BadgePiratesLLC/BSidesKC_2023/PICS/back.jpg

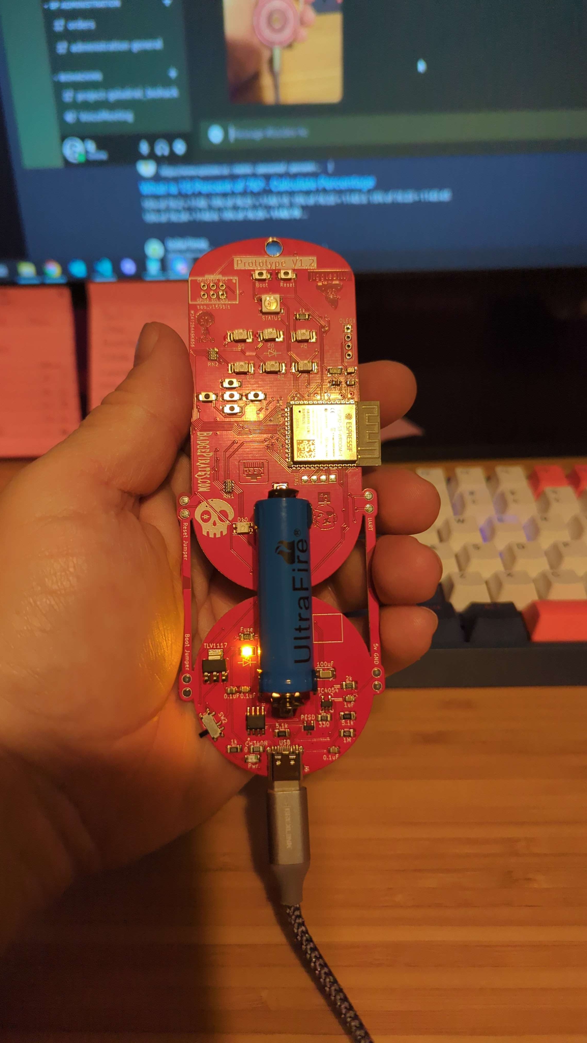
PICS/back.jpg
