BadgePiratesLLC/BSidesKC_2023/PICS/BSidesKC23_Front.png

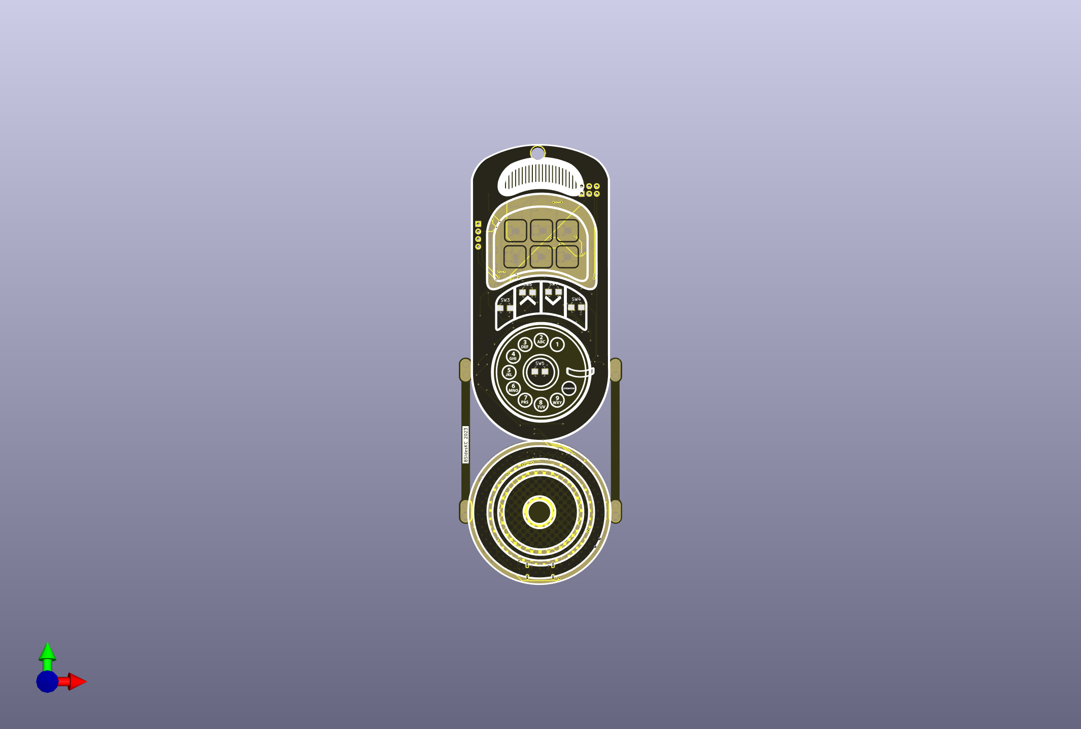
PICS/BSidesKC23_Front.png
