BadgePiratesLLC/BSidesKC_2023/DOCS/PinOut.txt

LEDS - IO10
LEDS - IO11
LEDS - IO12
LEDS - IO13
LEDS - IO14
LEDS - IO15

Status RGB - IO18

OLED SDA - IO06
OLED SDL - IO07

RGB - IO03
RGB - IO04
RGB - IO05

buttons Right - IO35
button Center - IO36
button Up - IO37
button Down - IO38
button Left - IO46
