BadgePiratesLLC/BSidesKC_2023/CTF/CTF Signs QR Codes.docx

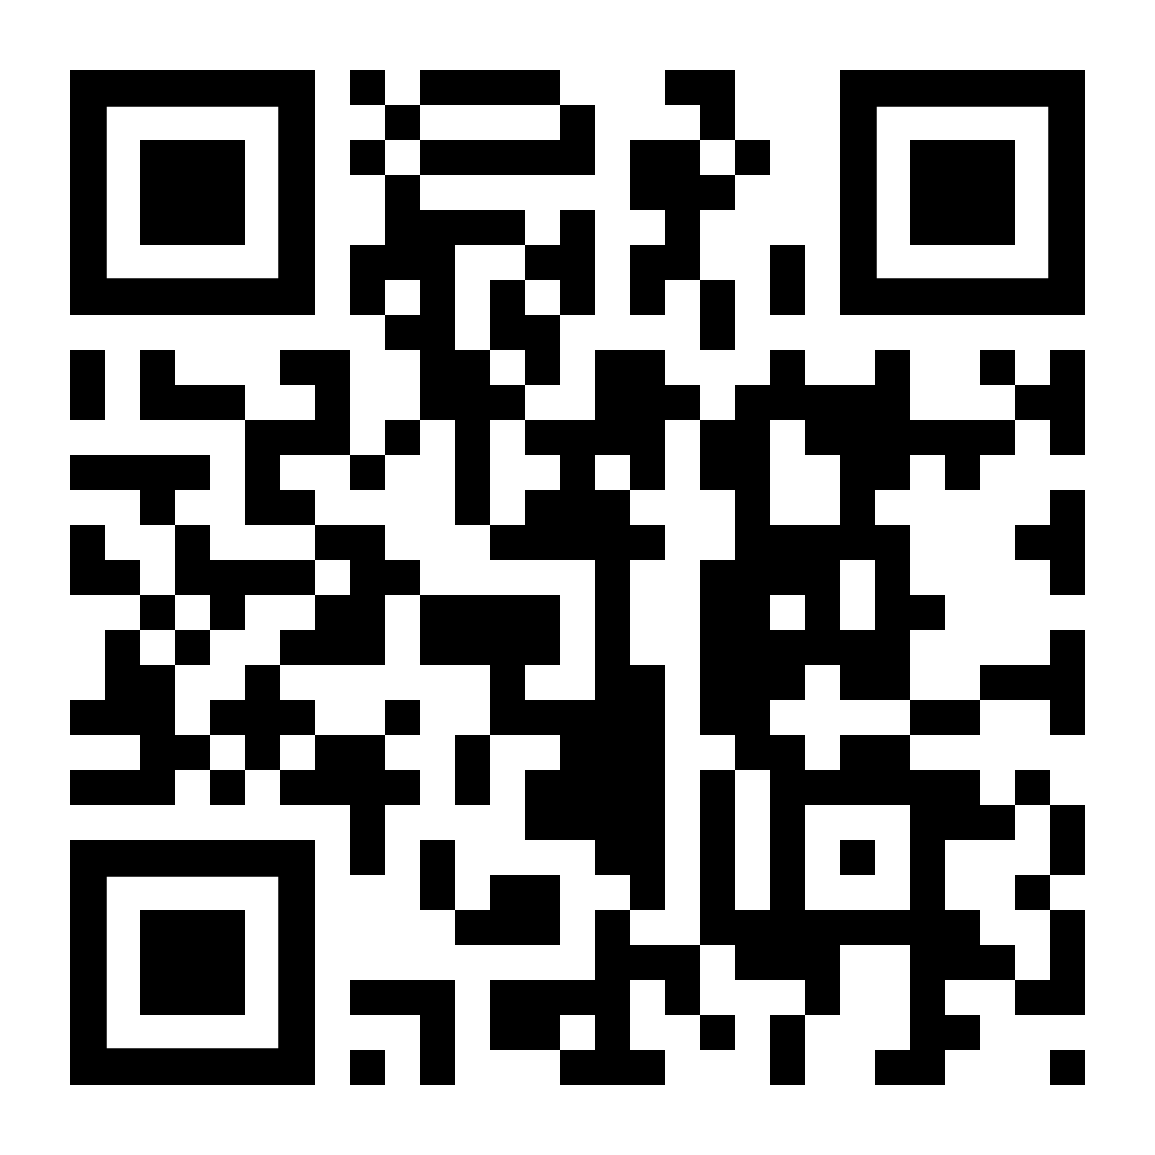
[picture p3: figure]

Badge CTF Starting Point

If you see this symbol, it is part of the Badge CTF

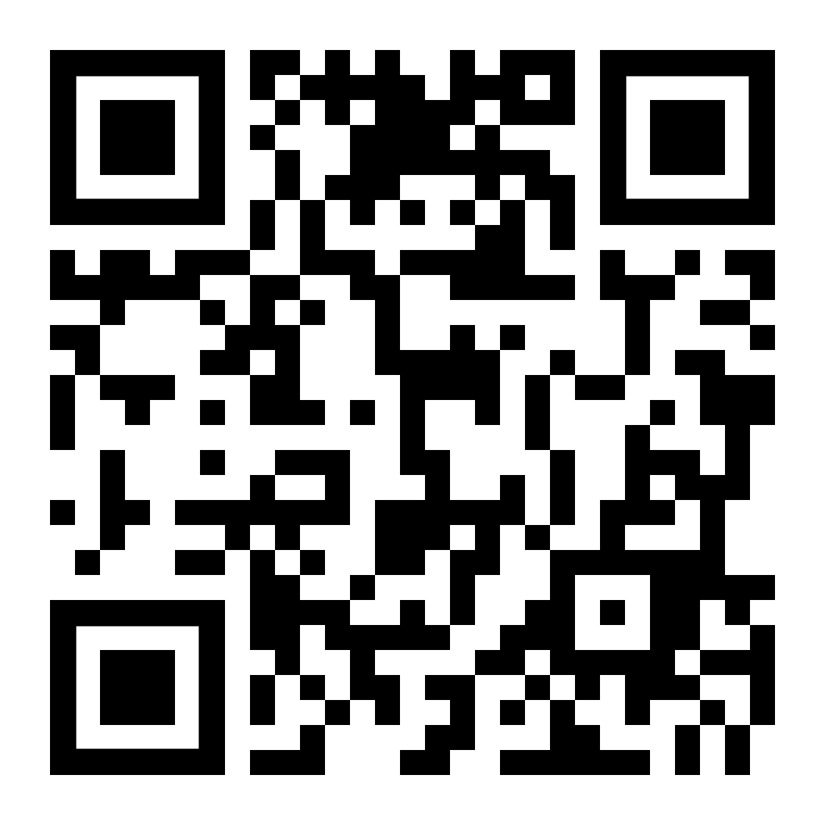
[picture p4: figure]

Lockpicking Village

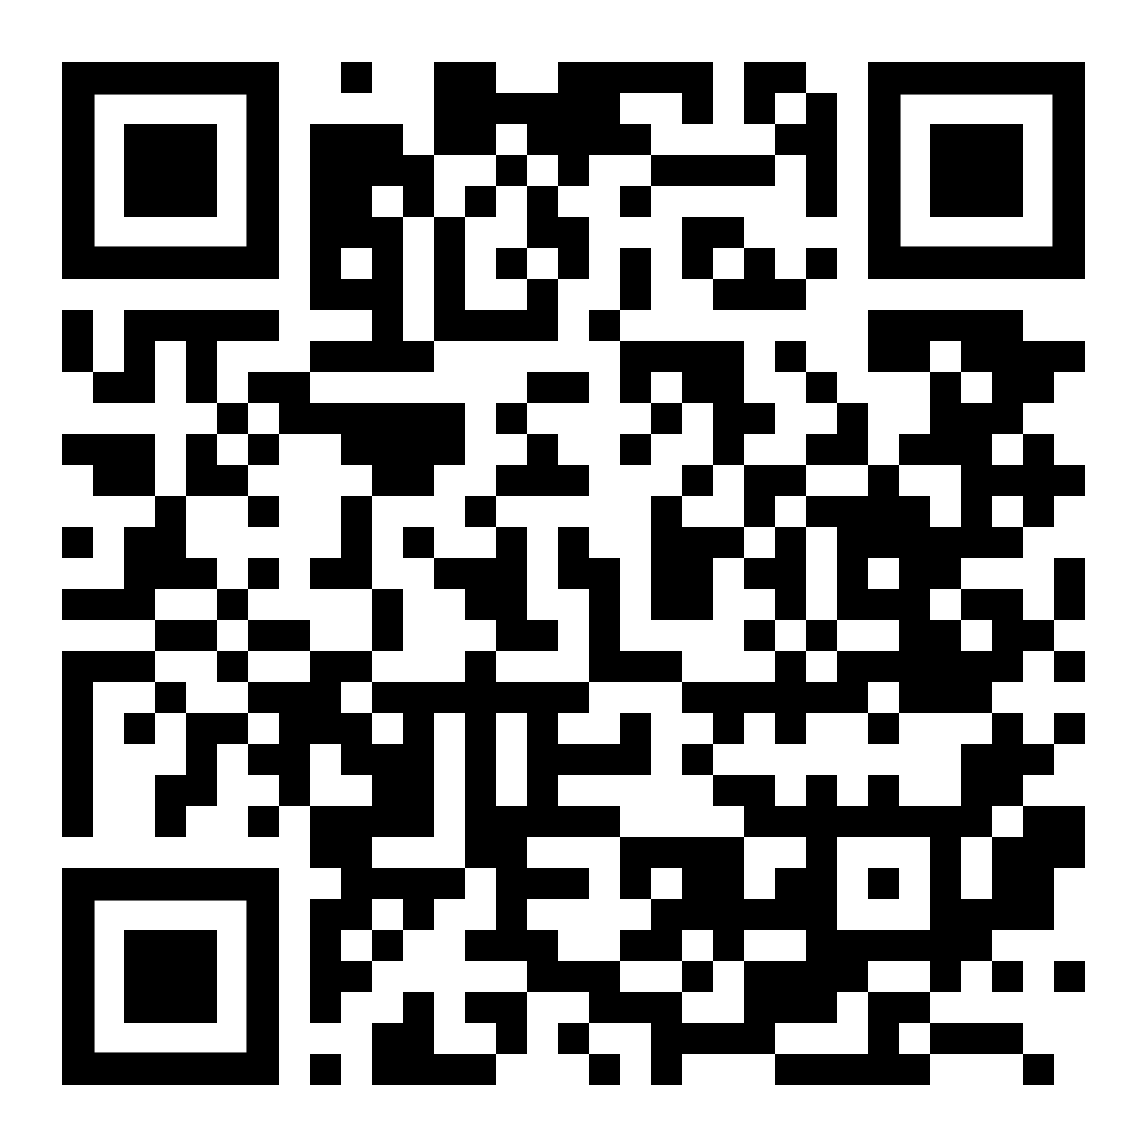
[picture p5: figure]

Hardware Hacking Village

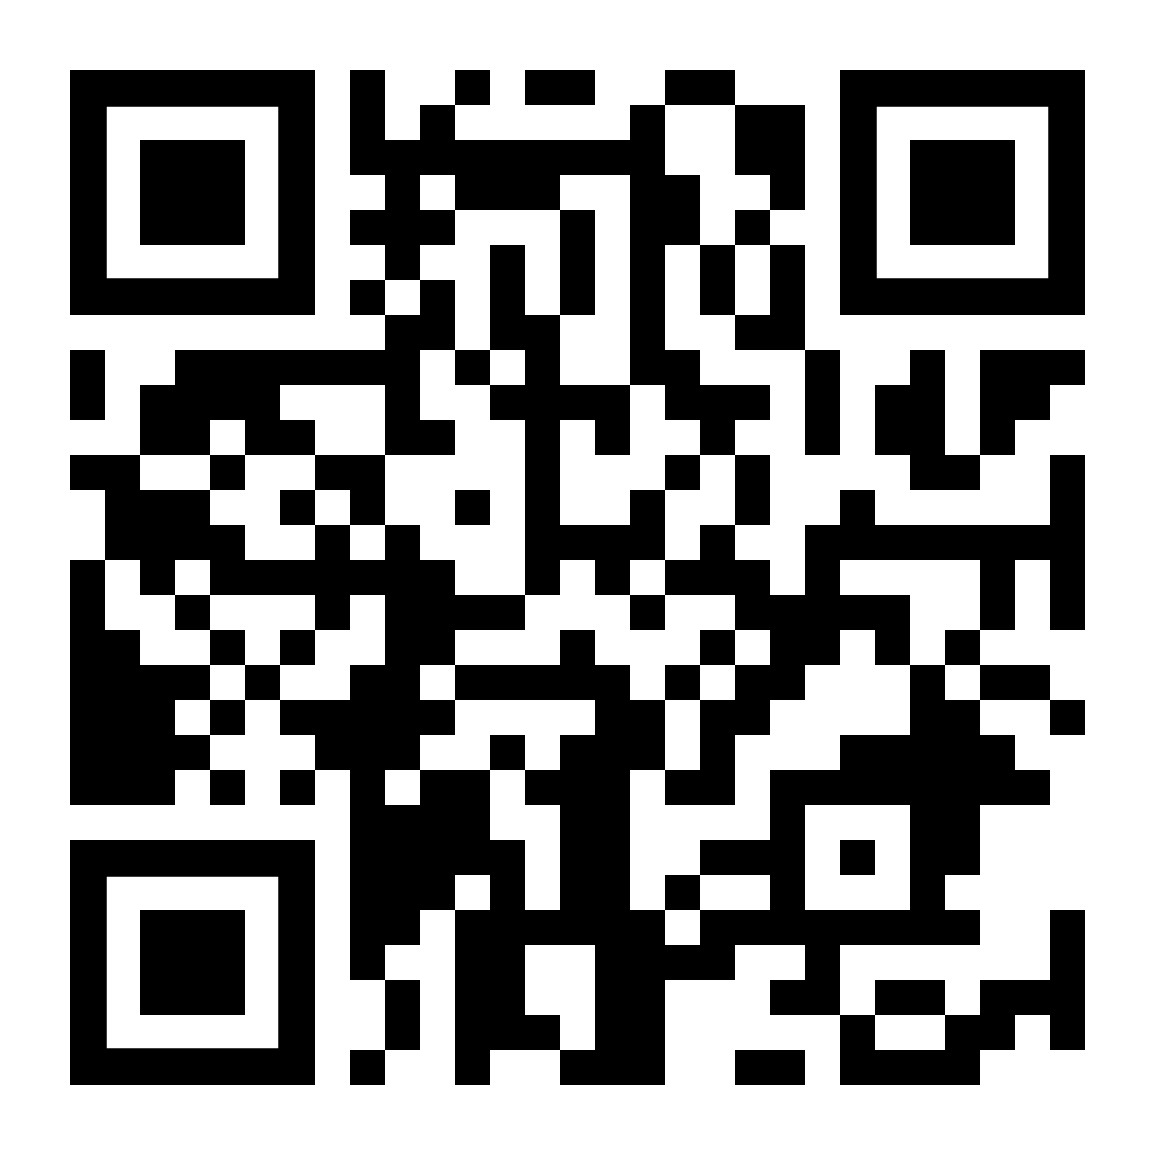
[picture p6: figure]

RF Village

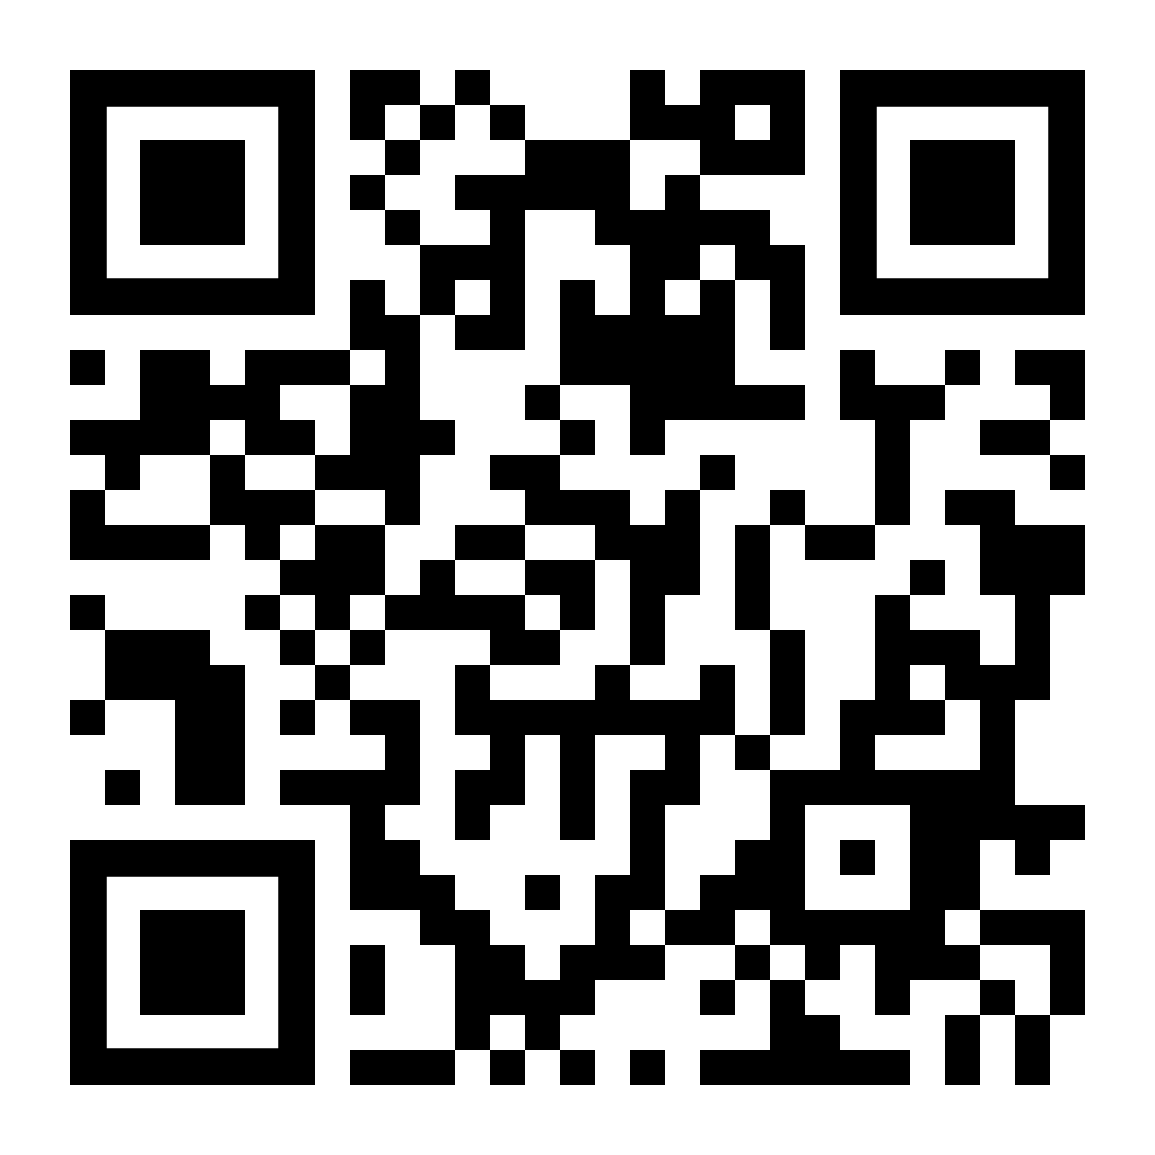
[picture p7: figure]

Scavenger Hunt
