BadgePiratesLLC/BSidesKC_2023/Artwork/CAD-Export/.svg2shenzhen-cache/images/F.Cu_g10784.png

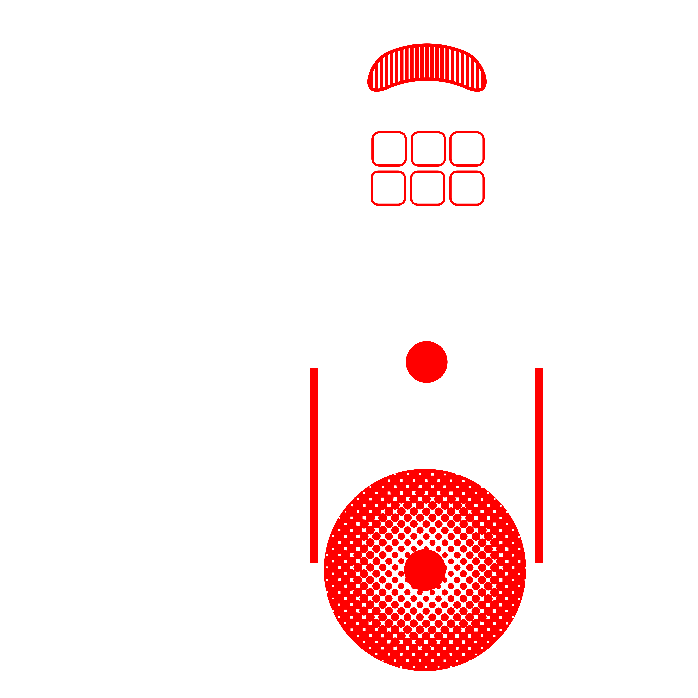
Artwork/CAD-Export/.svg2shenzhen-cache/images/F.Cu_g10784.png
