BadgePiratesLLC/BSidesKC_2023/Artwork/CAD-Export/.svg2shenzhen-cache/images/F.Mask_g10786.png

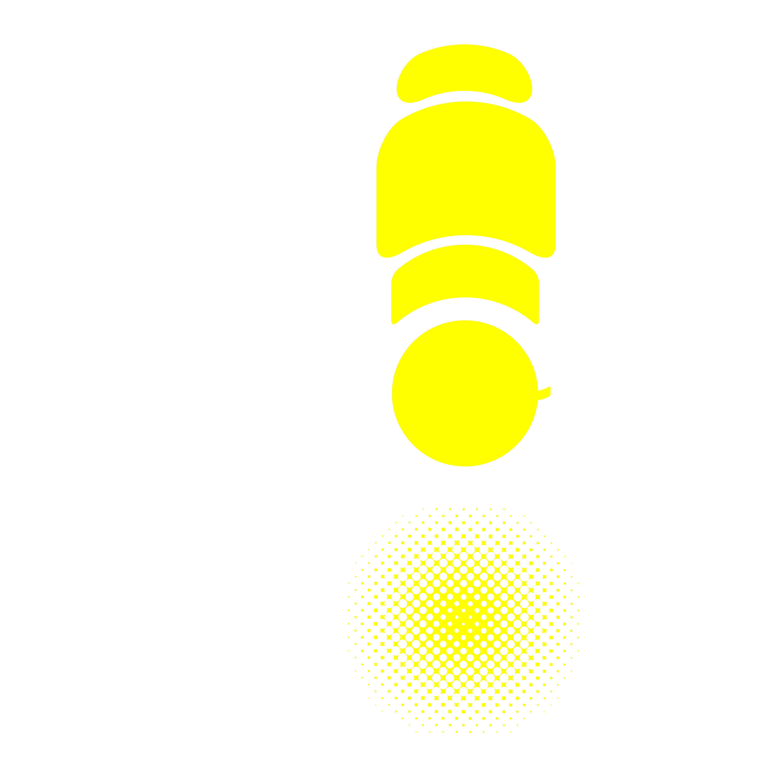
Artwork/CAD-Export/.svg2shenzhen-cache/images/F.Mask_g10786.png
