BadgePiratesLLC/BSidesKC_2023/Artwork/CAD-Export/.svg2shenzhen-cache/images/F.SilkS_g10789.png

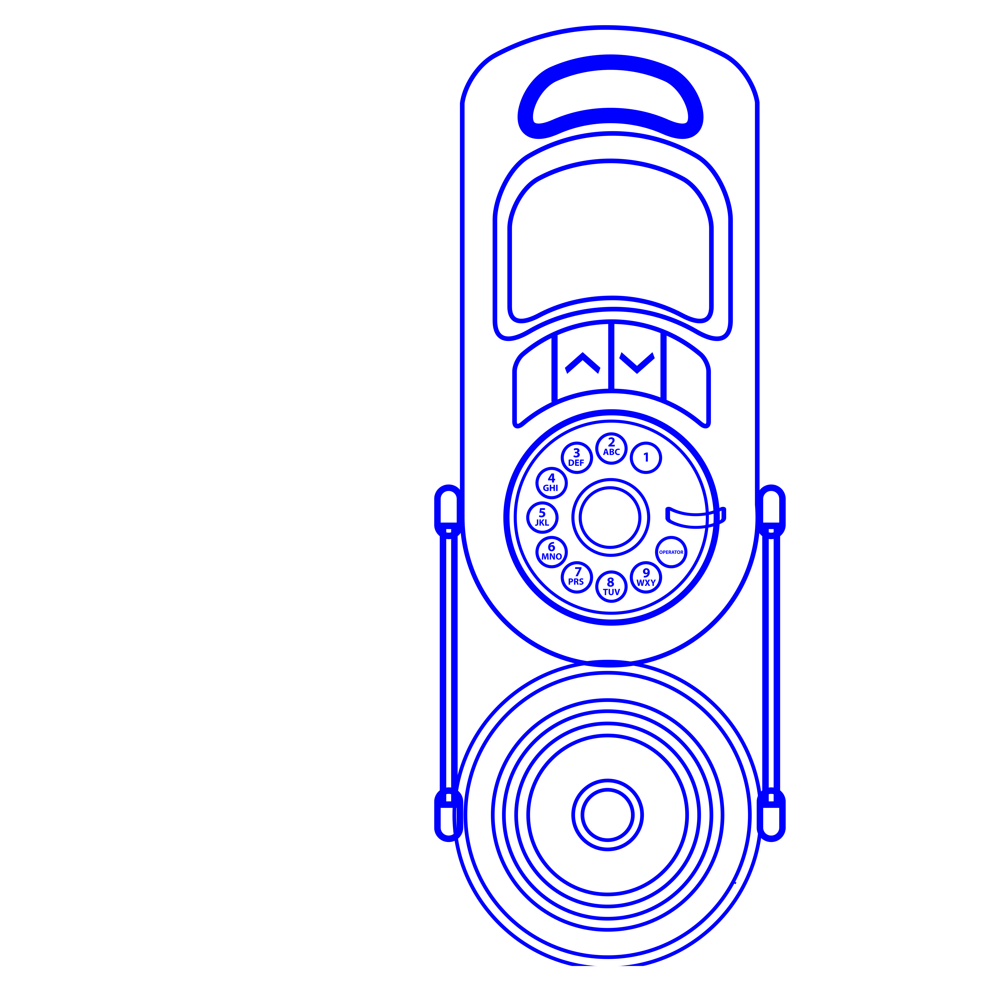
Artwork/CAD-Export/.svg2shenzhen-cache/images/F.SilkS_g10789.png
