BadgePiratesLLC/BSidesKC_2023/CTF/Evidence Envelope.png

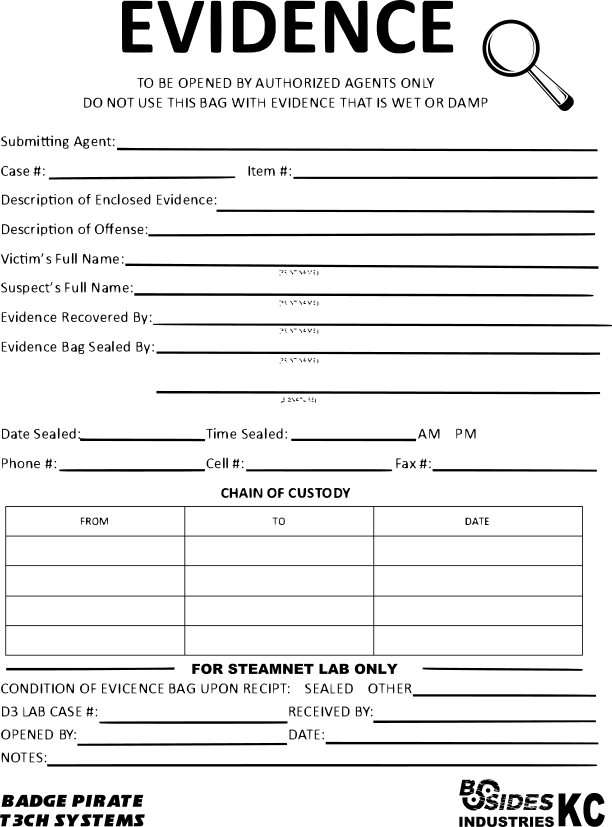
CTF/Evidence Envelope.png
