BadgePiratesLLC/BSidesKC_2023/PICS/front.jpg

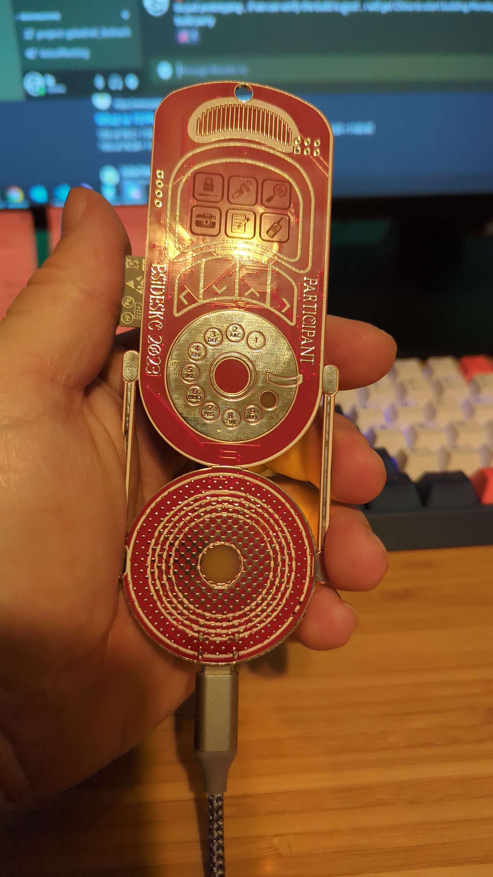
PICS/front.jpg
