BadgePiratesLLC/BSidesKC_2023/DOCS/KC_BOM.xlsx

Id | _1 | mfg Part # | Designator | Footprint | Quantity | Designation | Supplier and ref
1 | DNP |  | X1 | Badgelife-SAOv169-SAO_Side_B.SLK | 1 | sao_v169bis
2 | DNP |  | G*** | NG_B.Cu | 1 | NG_BSilk_B.Cu
3 | DNP |  | G***,G***,G***,G***,G***,G***,G*** | LOGO | 7 | LOGO
36 |  | 53 | BT1 | Battery Connectors | 2 | Battery | https://www.lcsc.com/product-detail/Battery-Connectors_Keystone-53_C5352788.html / https://www.digikey.com/en/products/detail/keystone-electronics/53TR/2137975
22 |  | CL21B104KBCNNNC | C1, C2, C3, C6, C8 | C_0805_2012Metric | 5 | 0.1uF
6 | DNP |  | G*** | FG_B.Cu | 1 | fg
7 | DNP |  | G*** | BPSkull_Distressed_B.SILK | 1 | BP Logo
8 | DNP |  | G*** | BadgePiratesURL_B.SLK | 1 | LOGO
9 | DNP |  | J3 | PinHeader_1x04_P2.54mm_Vertical | 1 | JTAG
35 |  | CL31A107MQHNNNE | C4 | C_1206_3216Metric | 1 | 100uF | https://www.lcsc.com/product-detail/Multilayer-Ceramic-Capacitors-MLCC-SMD-SMT_Samsung-Electro-Mechanics-CL31A107MQHNNNE_C15008.html
19 |  | CL21B105KBFNNNE | C5 | C_0805_2012Metric | 1 | 1uF | https://www.lcsc.com/product-detail/Multilayer-Ceramic-Capacitors-MLCC-SMD-SMT_Samsung-Electro-Mechanics-CL21B105KBFNNNE_C28323.html
31 |  | CL21A226MAYNNNE | C7 | C_0805_2012Metric | 1 | 22uF | https://www.lcsc.com/product-detail/Multilayer-Ceramic-Capacitors-MLCC-SMD-SMT_Samsung-Electro-Mechanics-CL21A226MAYNNNE_C602037.html
37 |  | NCD1206C1 | D1 | R_1206_3216Metric | 1 | Pwr - Green | https://www.lcsc.com/product-detail/Light-Emitting-Diodes-span-style-background-color-ff0-LED-span_Foshan-NationStar-Optoelectronics-NCD1206C1_C84273.html
13 |  | WS2812B 5050 | D10 | LED_WS2812B_PLCC4_5.0x5.0mm_P3.2mm | 1 | STATUS | https://www.lcsc.com/product-detail/Light-Emitting-Diodes-LED_Worldsemi-WS2812B-B-T_C2761795.html
18 |  | NCD1206B1 | D2 | LED_1206_3216Metric | 1 | Charging - blue | https://www.lcsc.com/product-detail/Light-Emitting-Diodes-span-style-background-color-ff0-LED-span_Foshan-NationStar-Optoelectronics-NCD1206B1_C130717.html
5 |  | XZMDKCBDDG45S-9 | D3 | LED_RGB_1210 | 1 | LED - RBG (gulwing) | https://www.digikey.com/en/products/detail/sunled/XZMDKCBDDG45S-9/4902045
4 |  | AA3528SURCKT09 | D4, D5, D6, D7, D8 D9 | LED_Osram_Lx_P47F_D2mm_ReverseMount_Proper_Mask Only | 6 | LED -Yellow (gulwing) | https://www.mouser.com/ProductDetail/Kingbright/AA3528SYCKT09?qs=PzGy0jfpSMsmUm0ELhsFuQ%3D%3D
14 |  | PESD2USB3UV-TR | D9 | SOT-23 | 1 | PESD | https://www.lcsc.com/product-detail/span-style-background-color-ff0-ESD-span-Protection-Devices_TECH-PUBLIC-PESD2USB3UV-TR_C7202955.html
26 |  | TLC-NSMD200 | F1 | R_1206_3216Metric | 1 | Fuse | https://www.lcsc.com/product-detail/Resettable-Fuses_TLC-Electronic-TLC-NSMD200_C261957.html
40 |  | 918-418K2023S40019 | J6 | USB_C_Receptical-Jing | 1 | USB_C | https://www.lcsc.com/product-detail/USB-Connectors_Jing-Extension-of-the-Electronic-Co-918-418K2023S40019_C709035.html
21 |  | SSD1306 128x32 | OLED1 | PinHeader_1x04_P2.54mm_Vertical | 1 | OLED | https://www.lcsc.com/product-detail/OLED-Displays-Modules_HS-HS91L02W2C01_C5248081.html
38 |  | RC1206FR-0710KL | R1 | R_1206_3216Metric | 1 | 10k | https://www.lcsc.com/product-detail/Chip-Resistor-Surface-Mount_YAGEO-RC1206FR-0710KL_C132649.html
34 |  | RC1206FR-071ML | R12 | R_1206_3216Metric | 1 | 1M | https://www.lcsc.com/product-detail/Chip-Resistor-Surface-Mount_YAGEO-RC1206FR-071ML_C108083.html
39 |  | RC1206FR-07330RL | R3 | R_1206_3216Metric | 1 | 330k | https://www.lcsc.com/product-detail/Chip-Resistor-Surface-Mount_YAGEO-RC1206FR-07330RL_C114944.html
42 |  | RC1206FR-072KL | R4 | R_1206_3216Metric | 1 | 2k | https://www.lcsc.com/product-detail/Chip-Resistor-Surface-Mount_YAGEO-RC1206FR-072KL_C133543.html
11 |  | RC1206FR-071KL | R5, R2 | R_1206_3216Metric | 2 | 1k
23 |  | RC1206FR-070RL | R6 | R_1206_3216Metric | 1 | 0 ohm | https://www.lcsc.com/product-detail/Chip-Resistor-Surface-Mount_YAGEO-RC1206FR-070RL_C137394.html
28 |  | RC1206FR-075K1L | R8, R10 | R_1206_3216Metric | 2 | 5.1k
10 |  | B3U-1000P | Reset | Switch_Tactile_SMD_B3U-1000P | 1 | Reset | https://www.lcsc.com/product-detail/_Omron-Electronics-_C231329.html
25 |  | YC164-JR-071KL | RN1 | R_Array_Convex_4x0603 | 1 | 1k_Array | https://www.lcsc.com/product-detail/Resistor-Networks-Arrays_YAGEO-YC164-JR-071KL_C93675.html
20 |  | YC164-JR-071KL | RN2 | R_Array_Convex_4x0603 | 1 | 1k_Array | https://www.lcsc.com/product-detail/Resistor-Networks-Arrays_YAGEO-YC164-JR-071KL_C93675.html
27 |  | B3U-1000P | SW1 | Switch_Tactile_SMD_B3U-1000P | 1 | Boot | https://www.lcsc.com/product-detail/_Omron-Electronics-_C231329.html
32 |  | SSSS811101 | SW2 | SW_SPDT_PCM12 | 1 | SW_SPDT | https://www.lcsc.com/product-detail/Slide-Switches_ALPSALPINE-SSSS811101_C109335.html
24 |  | B3S-1000 | SW3 | SW_SPST_B3S-1000 | 1 | SW_Left | https://www.lcsc.com/product-detail/_Omron-Electronics-_C231329.html
15 |  | B3S-1000 | SW4 | SW_SPST_B3S-1000 | 1 | SW_Up | https://www.lcsc.com/product-detail/_Omron-Electronics-_C231329.html
12 |  | B3S-1000 | SW5 | SW_SPST_B3S-1000 | 1 | SW_Center | https://www.lcsc.com/product-detail/_Omron-Electronics-_C231329.html
16 |  | B3S-1000 | SW6 | SW_SPST_B3S-1000 | 1 | SW_Right | https://www.lcsc.com/product-detail/_Omron-Electronics-_C231329.html
17 |  | B3S-1000 | SW7 | SW_SPST_B3S-1000 | 1 | SW_Down | https://www.lcsc.com/product-detail/_Omron-Electronics-_C231329.html
30 |  | CH340N | U1 | SOIC-8-1EP_W3.9mm | 1 | CH340N | https://www.lcsc.com/product-detail/USB-ICs_WCH-Jiangsu-Qin-Heng-CH340N_C2977777.html
29 |  | ESP32-S3-WROOM-1-N4 | U2 | ESP32-S3-WROOM-1 | 1 | ESP32-S3-WROOM-1 | https://www.lcsc.com/product-detail/WiFi-Modules_Espressif-Systems-ESP32-S3-WROOM-1-N4_C2913197.html
41 |  | TLV1117LV33DCYR | U3 | SOT-223 | 1 | TLV1117LV33DCYR | https://www.lcsc.com/product-detail/_Texas-Instruments-_C15578.html
33 |  | TP4054ST25K | U4 | LTC4054 | 1 | LTC4054 | https://www.lcsc.com/product-detail/Battery-Management-ICs_TPOWER-TP4054ST25K_C382138.html
 |  |  |  | 35 Unique components | 43 Total Components
