BadgePiratesLLC/BSidesKC_2023/(commit log)

2023-05-04 adding Boards
    [BSidesKC23.kicad_pcb, BSidesKC23.kicad_sch, USB_Connections.kicad_sch]
2023-05-14 updated functional Prototype
    [BSidesKC23.kicad_pcb, BSidesKC23.kicad_sch, USB_Connections.kicad_sch]
2023-05-14 adding Solder Kit Schametics
    [SolderKits.kicad_pcb, SolderKits.kicad_sch]
2023-05-14 adding footprints
    [SolderKits.kicad_pcb, SolderKits.kicad_sch]
2023-06-07 Test Export
    [badge.kicad_pcb]
2023-07-15 Adding Elect to board
    [BSidesKC23.kicad_pcb, BSidesKC23.kicad_sch, badge.kicad_pcb]
2023-07-18 Artwork to Board and Layout
    Lot o Work
    [BSidesKC23-B_Cu.gbr, BSidesKC23-B_Mask.gbr, BSidesKC23-B_Silkscreen.gbr, BSidesKC23-Edge_Cuts.gbr, BSidesKC23-F_Cu.gbr, BSidesKC23-F_Mask.gbr, BSidesKC23-F_Silkscreen.gbr, BSidesKC23-NPTH.drl]
2023-07-19 cleanup old design
    [badge.kicad_pcb]
2023-08-06 V2 of artwork
    Updating size (175mm)
    Incorporating changes
2023-08-11 Artwork V2
    [BsidesKC-Badge-V3.kicad_pcb, BsidesKC-Badge.kicad_pcb]
2023-08-12 Removed circles from copper layer
    Errant copper rings on bottom
    [BsidesKC-Badge-Final.kicad_pcb]
2023-08-13 Gerbers and finalize Traces
    [BSidesKC23-B_Cu.gbr, BSidesKC23-B_Mask.gbr, BSidesKC23-B_Silkscreen.gbr, BSidesKC23-Edge_Cuts.gbr, BSidesKC23-F_Cu.gbr, BSidesKC23-F_Mask.gbr, BSidesKC23-F_Silkscreen.gbr, BSidesKC23-NPTH.drl]
2023-08-21 fixing button spacing
    [BSidesKC23.kicad_pcb]
2023-08-22 Added badge personas
    Speaker, Village, Organizer
    [BsidesKC-Badge-Final-Organizer.kicad_pcb, BsidesKC-Badge-Final-Speaker.kicad_pcb, BsidesKC-Badge-Final-Village.kicad_pcb]
2023-08-22 Added Badge Pirates persona
    [BsidesKC-Badge-Final-Badge Pirates.kicad_pcb]
2023-08-22 update to logos and placements
    [BSidesKC23.kicad_pcb]
2023-08-22 fine tuning
    [BSidesKC23.kicad_pcb, BSidesKC23.kicad_sch, KC_BOM.xlsx, USB_Connections.kicad_sch]
2023-08-23 adding versions to CAD Folders
    [BSidesKC23-B_Cu.gbr, BSidesKC23-B_Mask.gbr, BSidesKC23-B_Silkscreen.gbr, BSidesKC23-Edge_Cuts.gbr, BSidesKC23-F_Cu.gbr, BSidesKC23-F_Mask.gbr, BSidesKC23-F_Silkscreen.gbr, BSidesKC23-NPTH.drl]
2023-08-23 Sponsor/Volunteer Versions
    [BsidesKC-Badge-Final-Sponsor.kicad_pcb, BsidesKC-Badge-Final-Volunteer.kicad_pcb]
2023-08-25 finishing up variants
    [BSidesKC23_BadgePirate-B_Cu.gbr, BSidesKC23_BadgePirate-B_Mask.gbr, BSidesKC23_BadgePirate-B_Silkscreen.gbr, BSidesKC23_BadgePirate-Edge_Cuts.gbr, BSidesKC23_BadgePirate-F_Cu.gbr, BSidesKC23_BadgePirate-F_Mask.gbr, BSidesKC23_BadgePirate-F_Silkscreen.gbr, BSidesKC23_BadgePirate-NPTH-drl_map.gbr]
2023-09-25 Bom and PNP updates
    [BSidesKC23.csv]
2023-10-04 Updated Village docs
    [BsidesKC 2023 - Learn to Solder Village Schedule.xlsx]
